enggsajjad/DRM/README.md

# DRM
Digital Rate Meter

##		Digital Frequency/Rate Meter 
Brief Description:	Development of Microcontroller based system to measure no. of pulses per second (0.001Hz-1KHz)
Detail:	The purpose of the project to build a low-cost rate meter, which measures at what frequency the signal is occurring. The user provided the description of the input signal and different type of actions which are to be taken under different rates.
Key Hardware:	8051 Microcontroller, Keypad, LCD
Software Tools:	Keil, OrCAD PCD Designing
Main activities and responsibilities:	Component Selection & Procurement
Designing the complete hardware prototype
Design and Development of printed circuit board (PCB)
Development of complete firmware for microcontroller (C)
Documentation
End Product:	Hardware Rack-mounted PCB and its casing
