enggsajjad/DRM/2012/Verilog/GenFreq/freq_pad.csv

Release 6.1i - Par G.23
Copyright (c) 1995-2003 Xilinx | Inc. All rights reserved.
Wed May 20 12:11:15 2009
NOTE: This file is designed to be imported into a spreadsheet program
such as Microsoft Excel for viewing | printing and sorting. The
character is used as the data field separator. This file is also designed
to support parsing.
INPUT FILE: freq_map.ncd
OUTPUT FILE: freq_pad.csv
PART TYPE: xc2s200
SPEED GRADE: -5
PACKAGE: pq208
Pinout by Pin Number:
----- | ----- | ----- | ----- | ----- | ----- | ----- | ----- | ----- | ----- | ----- | ----- | -----
Pin Number | Signal Name | Pin Usage | Pin Name | Direction | IO Standard | IO Bank Number | Drive (mA) | Slew Rate | Termination | IOB Delay | Voltage | Constraint
P1 |  |  | GND
P10 |  | IOB |  | UNUSED |  | (0 | 7)***
P100 |  | IOB | IO_VREF_4 | UNUSED |  | (0 | 4)***
P101 |  | IOB |  | UNUSED |  | (0 | 4)***
P102 |  | IOB |  | UNUSED |  | (0 | 4)***
P103 |  |  | GND
P104 |  |  | DONE
P105 |  |  | VCCO |  |  | 0 |  |  |  |  | na
P106 |  |  | PROGRAM
P107 |  | IOB | IO_INIT | UNUSED |  | (0 | 3)***
P108 |  | IOB | IO_D7 | UNUSED |  | (0 | 3)***
P109 |  | IOB | IO_VREF_3 | UNUSED |  | (0 | 3)***
P11 |  |  | GND
P110 |  | IOB |  | UNUSED |  | (0 | 3)***
P111 |  | IOB | IO_VREF_3 | UNUSED |  | (0 | 3)***
P112 |  | IOB |  | UNUSED |  | (0 | 3)***
P113 |  | IOB |  | UNUSED |  | (0 | 3)***
P114 |  | IOB | IO_VREF_3 | UNUSED |  | (0 | 3)***
P115 |  | IOB | IO_D6 | UNUSED |  | (0 | 3)***
P116 |  |  | GND
P117 |  |  | VCCO |  |  | 0 |  |  |  |  | na
P118 |  |  | VCCINT |  |  |  |  |  |  |  | 2.5
P119 |  | IOB | IO_D5 | UNUSED |  | (0 | 3)***
P12 |  |  | VCCO |  |  | 0 |  |  |  |  | na
P120 |  | IOB |  | UNUSED |  | (0 | 3)***
P121 |  | IOB |  | UNUSED |  | (0 | 3)***
P122 |  | IOB |  | UNUSED |  | (0 | 3)***
P123 |  | IOB |  | UNUSED |  | (0 | 3)***
P124 |  |  | GND
P125 |  | IOB | IO_VREF_3 | UNUSED |  | (0 | 3)***
P126 |  | IOB | IO_D4 | UNUSED |  | (0 | 3)***
P127 |  | IOB |  | UNUSED |  | (0 | 3)***
P128 |  |  | VCCINT |  |  |  |  |  |  |  | 2.5
P129 |  | PCIIOB | IO_TRDY | UNUSED |  | (0 | 3)***
P13 |  |  | VCCINT |  |  |  |  |  |  |  | 2.5
P130 |  |  | VCCO |  |  | 0 |  |  |  |  | na
P131 |  |  | GND
P132 |  | PCIIOB | IO_IRDY | UNUSED |  | (0 | 2)***
P133 |  | IOB |  | UNUSED |  | (0 | 2)***
P134 |  | IOB |  | UNUSED |  | (0 | 2)***
P135 |  | IOB | IO_D3 | UNUSED |  | (0 | 2)***
P136 |  | IOB | IO_VREF_2 | UNUSED |  | (0 | 2)***
P137 |  |  | GND
P138 |  | IOB |  | UNUSED |  | (0 | 2)***
P139 |  | IOB |  | UNUSED |  | (0 | 2)***
P14 |  | IOB |  | UNUSED |  | (0 | 7)***
P140 |  | IOB |  | UNUSED |  | (0 | 2)***
P141 |  | IOB |  | UNUSED |  | (0 | 2)***
P142 |  | IOB | IO_D2 | UNUSED |  | (0 | 2)***
P143 |  |  | VCCINT |  |  |  |  |  |  |  | 2.5
P144 |  |  | VCCO |  |  | 0 |  |  |  |  | na
P145 |  |  | GND
P146 |  | IOB | IO_D1 | UNUSED |  | (0 | 2)***
P147 |  | IOB | IO_VREF_2 | UNUSED |  | (0 | 2)***
P148 |  | IOB |  | UNUSED |  | (0 | 2)***
P149 |  | IOB |  | UNUSED |  | (0 | 2)***
P15 |  | IOB |  | UNUSED |  | (0 | 7)***
P150 |  | IOB | IO_VREF_2 | UNUSED |  | (0 | 2)***
P151 |  | IOB |  | UNUSED |  | (0 | 2)***
P152 |  | IOB | IO_VREF_2 | UNUSED |  | (0 | 2)***
P153 |  | IOB | IO_DIN_D0 | UNUSED |  | (0 | 2)***
P154 |  | IOB | IO_DOUT_BUSY | UNUSED |  | (0 | 2)***
P155 |  |  | CCLK
P156 |  |  | VCCO |  |  | 0 |  |  |  |  | na
P157 |  |  | TDO
P158 |  |  | GND
P159 |  |  | TDI
P16 |  | IOB |  | UNUSED |  | (0 | 7)***
P160 |  | IOB | IO_CS | UNUSED |  | (0 | 1)***
P161 |  | IOB | IO_WRITE | UNUSED |  | (0 | 1)***
P162 |  | IOB | IO_VREF_1 | UNUSED |  | (0 | 1)***
P163 |  | IOB |  | UNUSED |  | (0 | 1)***
P164 |  | IOB | IO_VREF_1 | UNUSED |  | (0 | 1)***
P165 |  | IOB |  | UNUSED |  | (0 | 1)***
P166 |  | IOB |  | UNUSED |  | (0 | 1)***
P167 |  | IOB | IO_VREF_1 | UNUSED |  | (0 | 1)***
P168 |  | IOB |  | UNUSED |  | (0 | 1)***
P169 |  |  | GND
P17 |  | IOB |  | UNUSED |  | (0 | 7)***
P170 |  |  | VCCO |  |  | 0 |  |  |  |  | na
P171 |  |  | VCCINT |  |  |  |  |  |  |  | 2.5
P172 |  | IOB |  | UNUSED |  | (0 | 1)***
P173 |  | IOB |  | UNUSED |  | (0 | 1)***
P174 |  | IOB |  | UNUSED |  | (0 | 1)***
P175 |  | IOB |  | UNUSED |  | (0 | 1)***
P176 |  | IOB |  | UNUSED |  | (0 | 1)***
P177 |  |  | GND
P178 |  | IOB | IO_VREF_1 | UNUSED |  | (0 | 1)***
P179 |  | IOB |  | UNUSED |  | (0 | 1)***
P18 |  | IOB |  | UNUSED |  | (0 | 7)***
P180 |  | IOB |  | UNUSED |  | (0 | 1)***
P181 |  | IOB |  | UNUSED |  | (0 | 1)***
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
P89 |  | IOB |  | UNUSED |  | (0 | 4)***
P9 |  | IOB | IO_VREF_7 | UNUSED |  | (0 | 7)***
P90 |  | IOB |  | UNUSED |  | (0 | 4)***
P91 |  |  | VCCINT |  |  |  |  |  |  |  | 2.5
P92 |  |  | VCCO |  |  | 0 |  |  |  |  | na
P93 |  |  | GND
P94 |  | IOB |  | UNUSED |  | (0 | 4)***
P95 |  | IOB | IO_VREF_4 | UNUSED |  | (0 | 4)***
P96 |  | IOB |  | UNUSED |  | (0 | 4)***
P97 |  | IOB |  | UNUSED |  | (0 | 4)***
P98 |  | IOB | IO_VREF_4 | UNUSED |  | (0 | 4)***
P99 |  | IOB |  | UNUSED |  | (0 | 4)***
----- | ----- | ----- | ----- | ----- | ----- | ----- | ----- | ----- | ----- | ----- | ----- | -----
* Default value.
** This default Pullup/Pulldown value can be overridden in Bitgen.
*** In some smaller packages | the VCCO bank number of a pin may trail
the VREF bank number (VCCO | VREF).
