enggsajjad/DRM/(list of files, cad)

Other CAD files:
2012/DRM-3.5 CD May2012/Micrcontroller/rm_pca4.2/main.obj
2012/DRM-3.5 CD May2012/Micrcontroller/rm_pca4.2/readme.obj
2012/DRM-3.5 CD May2012/Micrcontroller/rm_pca2.0_old/main.obj
2012/DRM-3.5 CD May2012/Micrcontroller/rm_pca2.0_old/readme.obj
