enggsajjad/DRM/2012/DRM-3.5 CD May2012/PCB Design/DRM-3.5/PDF/DRM-3.5_ALL.pdf

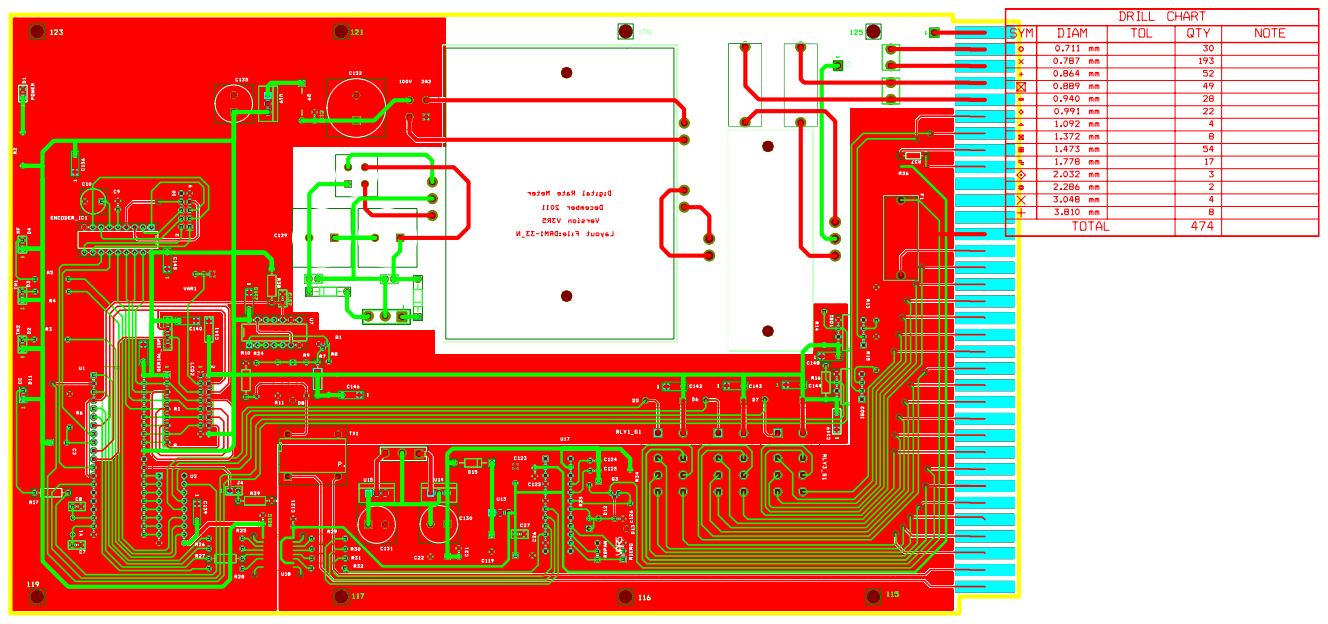
[picture p1: page 1]
