enggsajjad/DRM/2012/DRM-3.5 CD May2012/PCB Design/DRM-3.5/PDF/DRM-3.5_Schematic.pdf

10

9

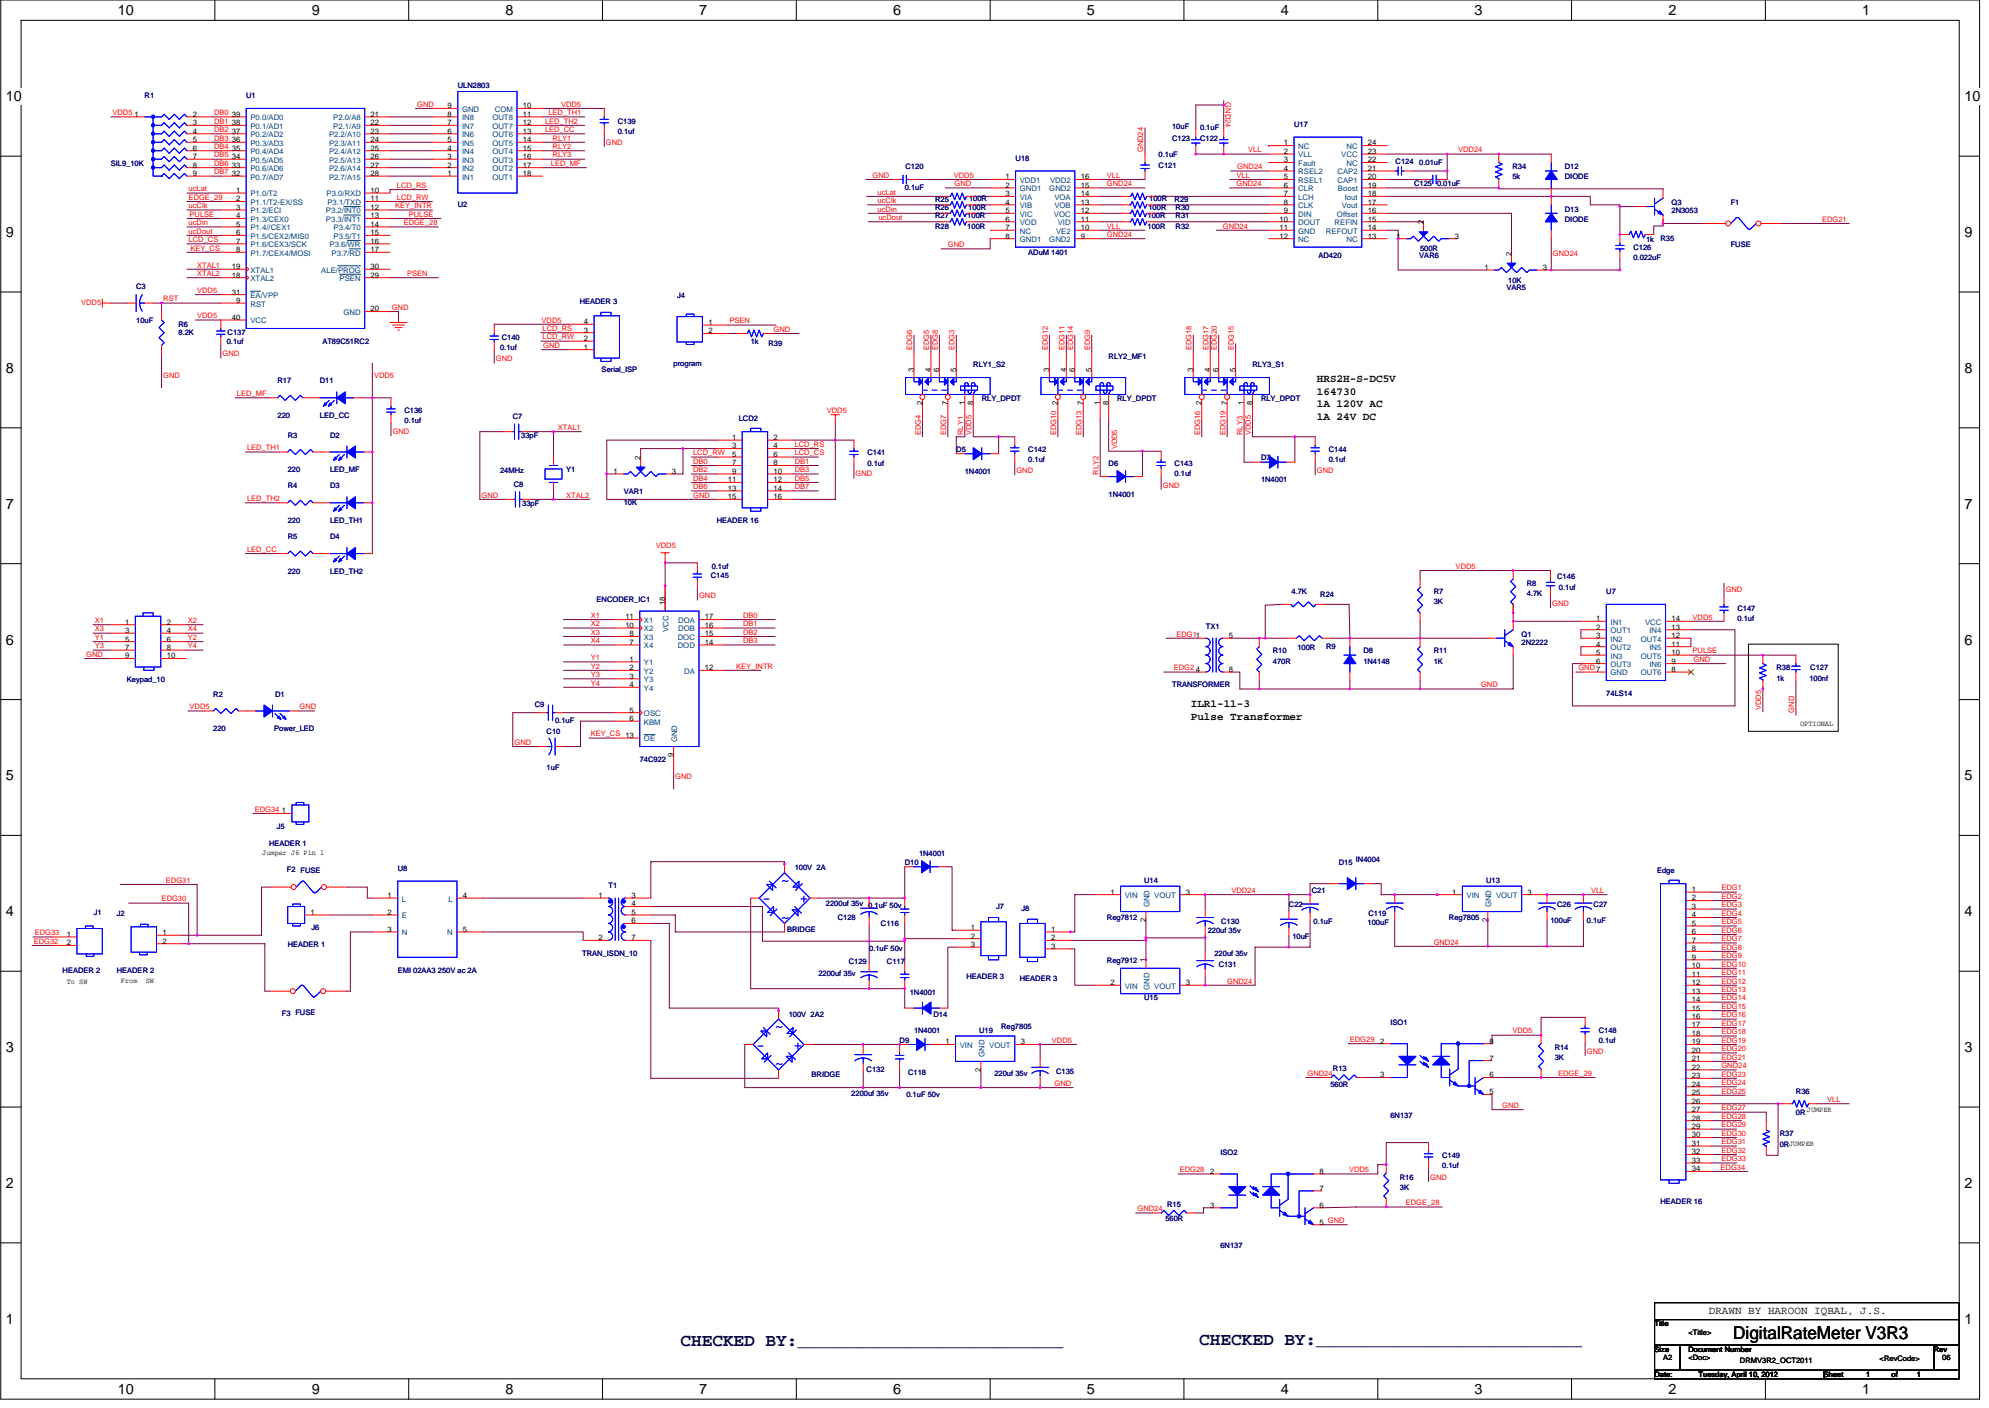
[picture p3: page 1]

DRAWN BY HAROON IQBAL, J.S.
DigitalRateMeter V3R3

Size Size Size Size Size Size A2 A2 A2 | Document Number Document Number Document Number Document Number Document Number Document Number <Doc> <Doc> <Doc> DRMV3R2_OCT2011 DRMV3R2_OCT2011 DRMV3R2_OCT2011 <RevCode> <RevCode> <RevCode> | Rev Rev Rev Rev Rev Rev 06 06 06

Date: Date: Date: Date: Date: Date: Tuesday, April 10, 2012 Tuesday, April 10, 2012 Tuesday, April 10, 2012 Tuesday, April 10, 2012 Tuesday, April 10, 2012 Tuesday, April 10, 2012 | Sheet Sheet Sheet Sheet Sheet Sheet 1 1 1 1 1 1 of of of of of of 1 1 1 1 1 1
