enggsajjad/DRM/(list of files, drawings)

Other design files:
2012/DRM-3.5 CD May2012/PCB Design/DRM-3.5 Programming Cable/SERIAL.DSN
2012/DRM-3.5 CD May2012/PCB Design/DRM-3.5 Programming Cable/Serial.opj
2012/DRM-3.5 CD May2012/PCB Design/DRM-3.5/DRM V3R5/DRM1.DSN
2012/DRM-3.5 CD May2012/PCB Design/DRM-3.5/DRM V3R5/DRM1.opj
2012/DRM-3.5 CD May2012/PCB Design/Tester/Schematics/DRM_TEST.DSN
2012/DRM-3.5 CD May2012/PCB Design/Tester/Schematics/DRM_TEST.opj
